wright-group/FilterWheels/chassis/large mount - continuous ND/left side.pdf

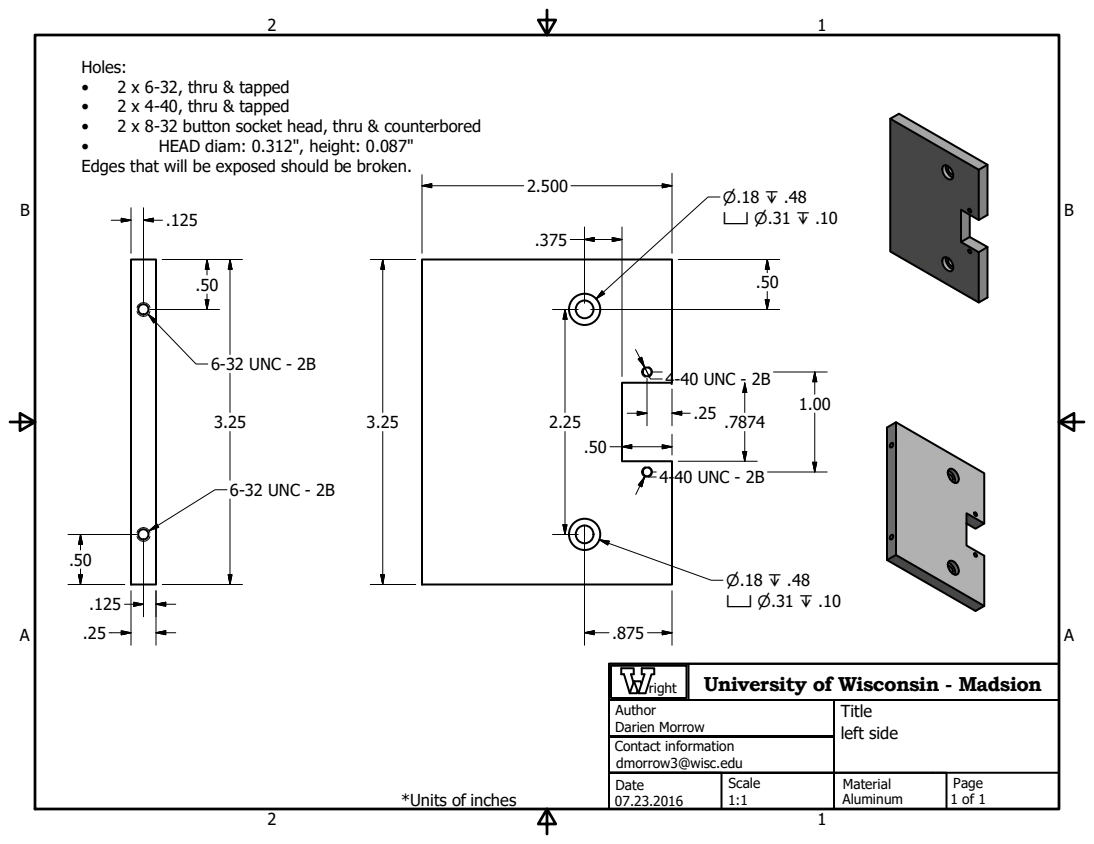
[picture p1: page 1]
Darien Morrow; dmorrow3@wisc.edu; Aluminum; left side; Author; Date; Scale; Title; Material; Page; Contact information; right; 6-32 UNC - 2B; 4-40 UNC - 2B

Holes:
• 2 x 6-32, thru & tapped
• 2 x 4-40, thru & tapped
• 2 x 8-32 button socket head, thru & counterbored
• HEAD diam: 0.312", height: 0.087"
Edges that will be exposed should be broken.

University of Wisconsin - Madsion

*Units of inches
